ryan-james-thomas/analog-pi-servo/LaserPID.kicad_pcb

## KiCad design LaserPID.kicad_pcb (2024-05-08)

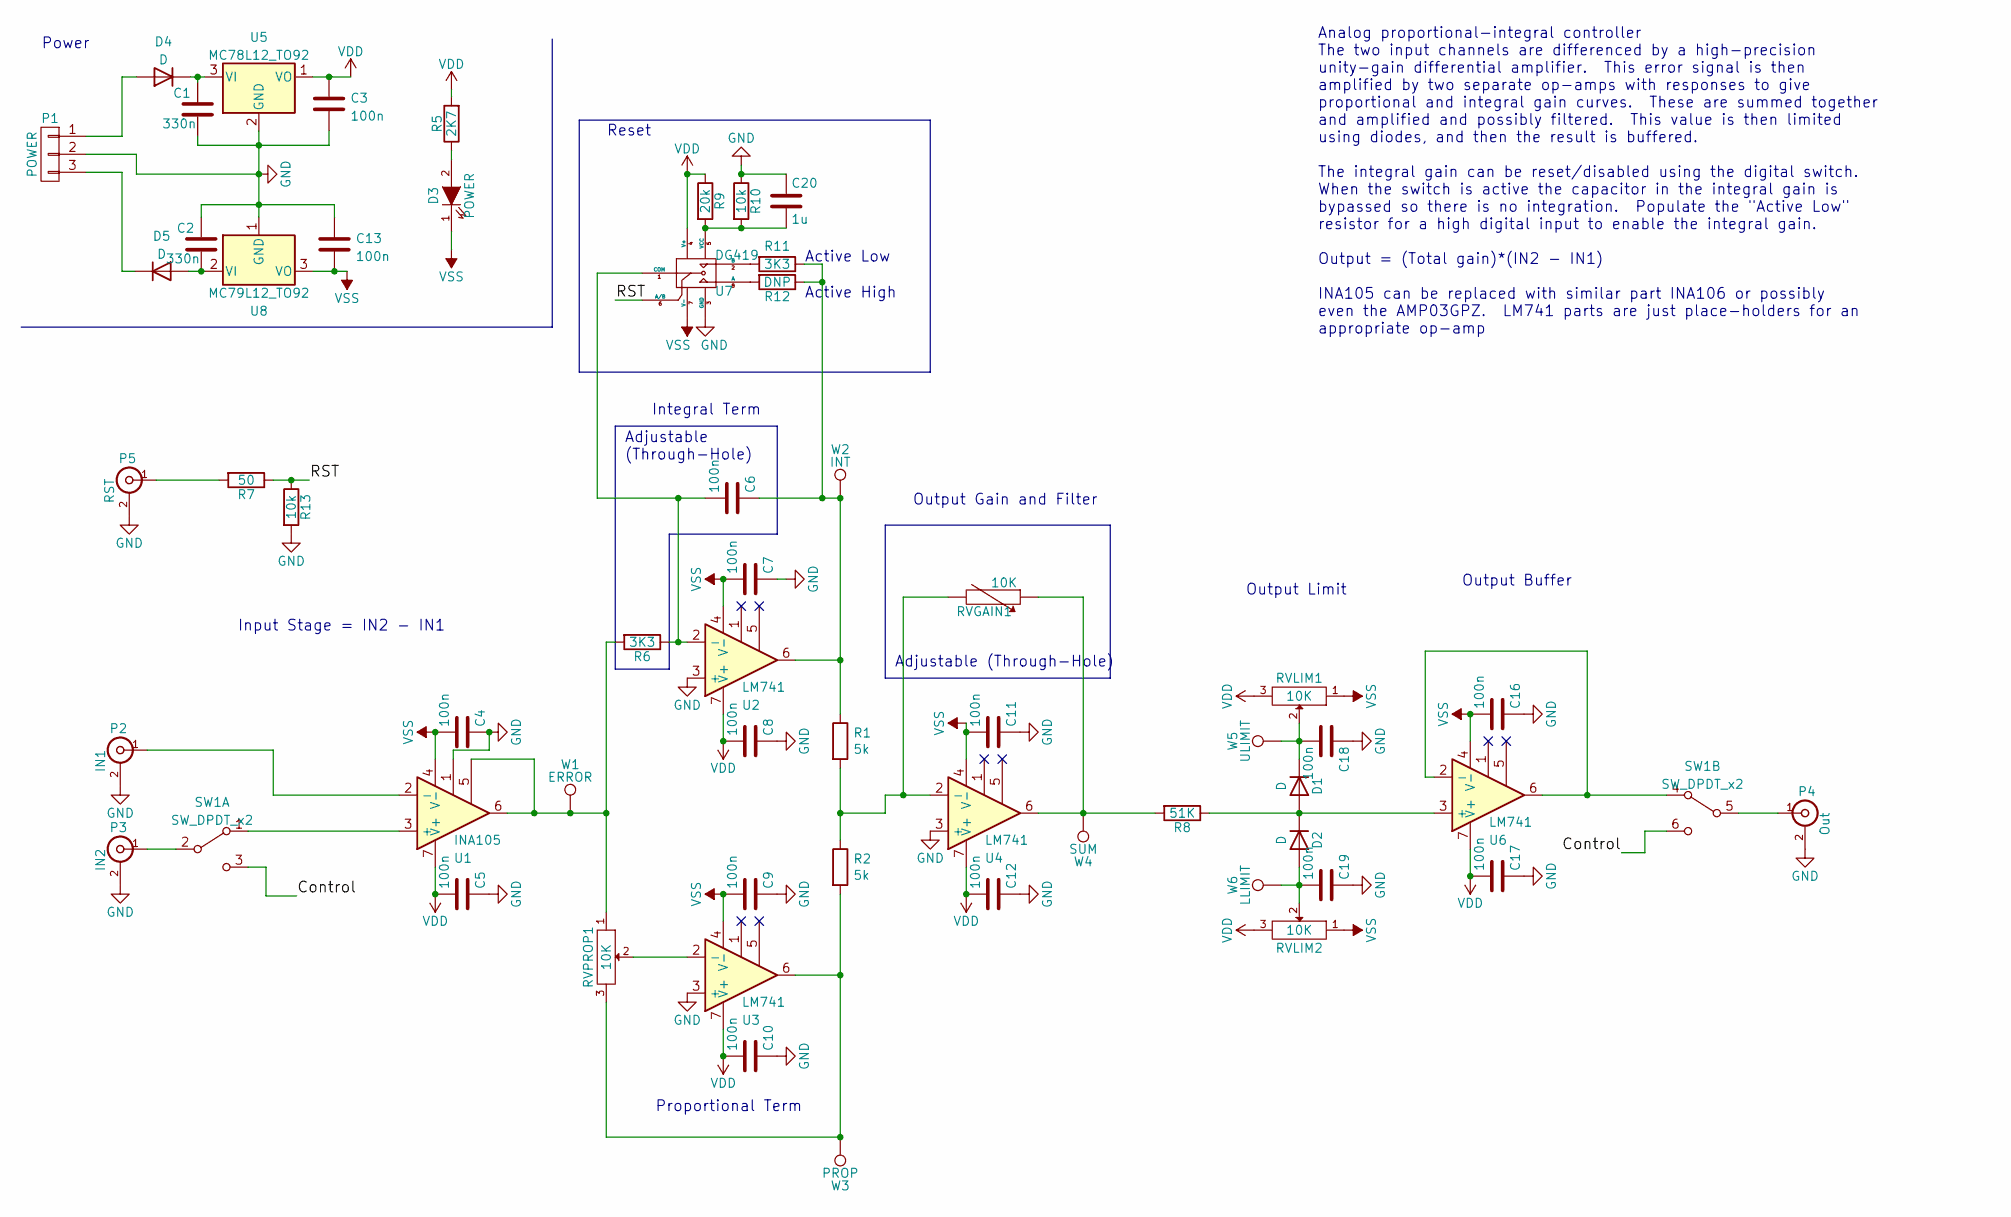
[picture p1: schematic LaserPID.kicad_sch, PI Contoller]

Parts:
C1, C2: 330n; C_1206_3216Metric_Pad1.33x1.80mm_HandSolder; Digikey Part Number 4713-GMC31X7R334K50NTCT-ND
C3, C4, C5, C7, C8, C9, C10, C11, C12, C13, C16, C17, C18, C19: 100n; C_1206_3216Metric_Pad1.33x1.80mm_HandSolder; Digikey Part Number 478-1556-1-ND
C6: 100n; R_Universal_L13.0mm_W4.0mm_P9.00mm
C20: 1u; C_1206_3216Metric_Pad1.33x1.80mm_HandSolder; Digikey Part Number 1276-2747-1-ND‎
D1, D2: D; D_DO-35_SOD27_P7.62mm_Horizontal; Digikey Part Number 1N4148FSCT-ND
D3: POWER; LED_D3.0mm; Digikey Part Number 732-5008-ND
D4, D5: D; D_1206_3216Metric_Pad1.42x1.75mm_HandSolder; Digikey Part Number 478-7806-1-ND
P1: POWER; TerminalBlock_bornier-3_P5.08mm; Digikey Part Number 2057-EBBA-03-C-SS-BU-ND
P2: IN1; BNC_Amphenol_B6252HB-NPP3G-50_Horizontal; Digikey Part Number ARF1690-ND
P3: IN2; BNC_Amphenol_B6252HB-NPP3G-50_Horizontal; Digikey Part Number ARF1690-ND
P4: Out; BNC_Amphenol_B6252HB-NPP3G-50_Horizontal; Digikey Part Number ARF1690-ND
P5: RST; BNC_Amphenol_B6252HB-NPP3G-50_Horizontal; Digikey Part Number ARF1690-ND
R1, R2: 5k; R_1206_3216Metric_Pad1.30x1.75mm_HandSolder; Digikey Part Number YAG5090CT-ND
R5: 2K7; R_1206_3216Metric_Pad1.30x1.75mm_HandSolder; Digikey Part Number RMCF1206JT2K70CT-ND
R6: 3K3; R_Universal_L13.0mm_W4.0mm_P9.00mm; Digikey Part Number RMCF1206JT3K30CT-ND
R7: 50; R_1206_3216Metric_Pad1.30x1.75mm_HandSolder; Digikey Part Number 541-2477-1-ND
R8: 51K; R_1206_3216Metric_Pad1.30x1.75mm_HandSolder; Digikey Part Number RMCF1206JT51K0CT-ND
R9: 20k; R_1206_3216Metric_Pad1.30x1.75mm_HandSolder; Digikey Part Number RMCF1206JT20K0CT-ND
R10, R13: 10k; R_1206_3216Metric_Pad1.30x1.75mm_HandSolder; Digikey Part Number RMCF1206JT10K0CT-ND
R11: 3K3; R_1206_3216Metric_Pad1.30x1.75mm_HandSolder; Digikey Part Number RMCF1206JT3K30CT-ND
R12: DNP; R_1206_3216Metric_Pad1.30x1.75mm_HandSolder
RVGAIN1: 10K; Potentiometer_Bourns_3296W_Vertical; Digikey Part Number 3296W-103LF-ND
RVLIM1, RVLIM2: 10K; Potentiometer_Bourns_3296W_Vertical; Digikey Part Number 3296W-103LF-ND
RVPROP1: 10K; Potentiometer_Bourns_3296W_Vertical; Digikey Part Number 3296W-103LF-ND
SW1: SW_DPDT_x2; DPDT_SW_ADAM_TECH; Digikey Part Number 2057-SW-T3-4B-A-A3-S2-ND
U1: INA105; DIP-8_W7.62mm_Socket; Digikey Part Number AMP03GPZ-ND
U2, U3, U4, U6: LM741; DIP-8_W7.62mm_Socket; Digikey Part Number 296-34251-5-ND
U5: MC78L12_TO92; TO-92_Inline; Digikey Part Number MC78L12ACPGOS-ND
U7: DG419; SOIC-8_3.9x4.9mm_P1.27mm; Digikey Part Number DG469EY-T1-E3CT-ND
U8: MC79L12_TO92; TO-92_Inline; Digikey Part Number MC79L12ACPGOS-ND
W1: ERROR; TestPoint_THTPad_D1.0mm_Drill0.5mm
W2: INT; TestPoint_THTPad_D1.0mm_Drill0.5mm
W3: PROP; TestPoint_THTPad_D1.0mm_Drill0.5mm
W4: SUM; TestPoint_THTPad_D1.0mm_Drill0.5mm
W5: ULIMIT; TestPoint_THTPad_D1.0mm_Drill0.5mm
W6: LLIMIT; TestPoint_THTPad_D1.0mm_Drill0.5mm

Connections:
/Control: SW1.3 (C), SW1.6 (C)
/RST: R7.1, R13.1, U7.6 (A/B)
GND: C1.2, C2.1, C3.2, C4.1, C5.1, C7.1, C8.1, C9.1, C10.1, C11.1, C12.1, C13.1, C16.1, C17.1, C18.1, C19.1, C20.1, P1.2, P2.2 (Ext), P3.2 (Ext), P4.2 (Ext), P5.2 (Ext), R10.1, R13.2, U1.1, U2.3 (+), U3.3 (+), U4.3 (+), U5.2 (GND), U7.3 (GND), U8.1 (GND)
unnamed: C6.1, R1.1, R11.1, R12.1, U2.6, W2.1
unnamed: C6.2, R6.1, U2.2 (-), U7.1 (COM)
unnamed 5: C18.2, D1.1 (K), RVLIM1.2, W5.1; also elsewhere on the board
unnamed 6: C19.2, D2.2 (A), RVLIM2.2, W6.1; also elsewhere on the board
unnamed: C20.2, R9.2, R10.2, U7.5 (VCC)
unnamed: D1.2 (A), D2.1 (K), R8.1, U6.3 (+)
unnamed: D3.2 (A), R5.1
unnamed: C1.1, D4.1 (K), U5.3 (VI)
unnamed: C2.2, D5.2 (A), U8.2 (VI)
unnamed: D4.2 (A), P1.1
unnamed: D5.1 (K), P1.3
unnamed: P2.1 (In), U1.2 (-)
unnamed: P3.1 (In), SW1.2 (B)
unnamed: P4.1 (In), SW1.5 (B)
unnamed: R1.2, R2.1, RVGAIN1.2, U4.2 (-)
unnamed: R2.2, RVPROP1.3, U3.6, W3.1
unnamed: R6.2, RVPROP1.1, U1.5, U1.6, W1.1
unnamed: P5.1 (In), R7.2
unnamed: R11.2, U7.2 (B)
unnamed: R12.2, U7.8 (A)
unnamed: R8.2, RVGAIN1.1, U4.6, W4.1
unnamed: RVPROP1.2, U3.2 (-)
unnamed: SW1.1 (A), U1.3 (+)
unnamed: SW1.4 (A), U6.2 (-), U6.6
VDD: C3.1, C5.2, C8.2, C10.2, C12.2, C17.2, R5.2, R9.1, RVLIM1.3, RVLIM2.3, U1.7 (V+), U2.7 (V+), U3.7 (V+), U4.7 (V+), U5.1 (VO), U6.7 (V+), U7.4 (V+); also elsewhere on the board
VSS: C4.2, C7.2, C9.2, C11.2, C13.2, C16.2, D3.1 (K), RVLIM1.1, RVLIM2.1, U1.4 (V-), U2.4 (V-), U3.4 (V-), U4.4 (V-), U6.4 (V-), U7.7 (V-), U8.3 (VO); also elsewhere on the board

Notes on the sheet:
Reset
Output Limit
Active High
Proportional Term
Input Stage = IN2 - IN1
Analog proportional-integral controller The two input channels are differenced by a high-precision unity-gain differential amplifier. This error signal is then amplified by two separate op-amps with responses to give proportional and integral gain curves. These are summed together and amplified and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
Output Buffer
Output Gain and Filter
Power
Adjustable (Through-Hole)
Integral Term
Active Low
Adjustable (Through-Hole)

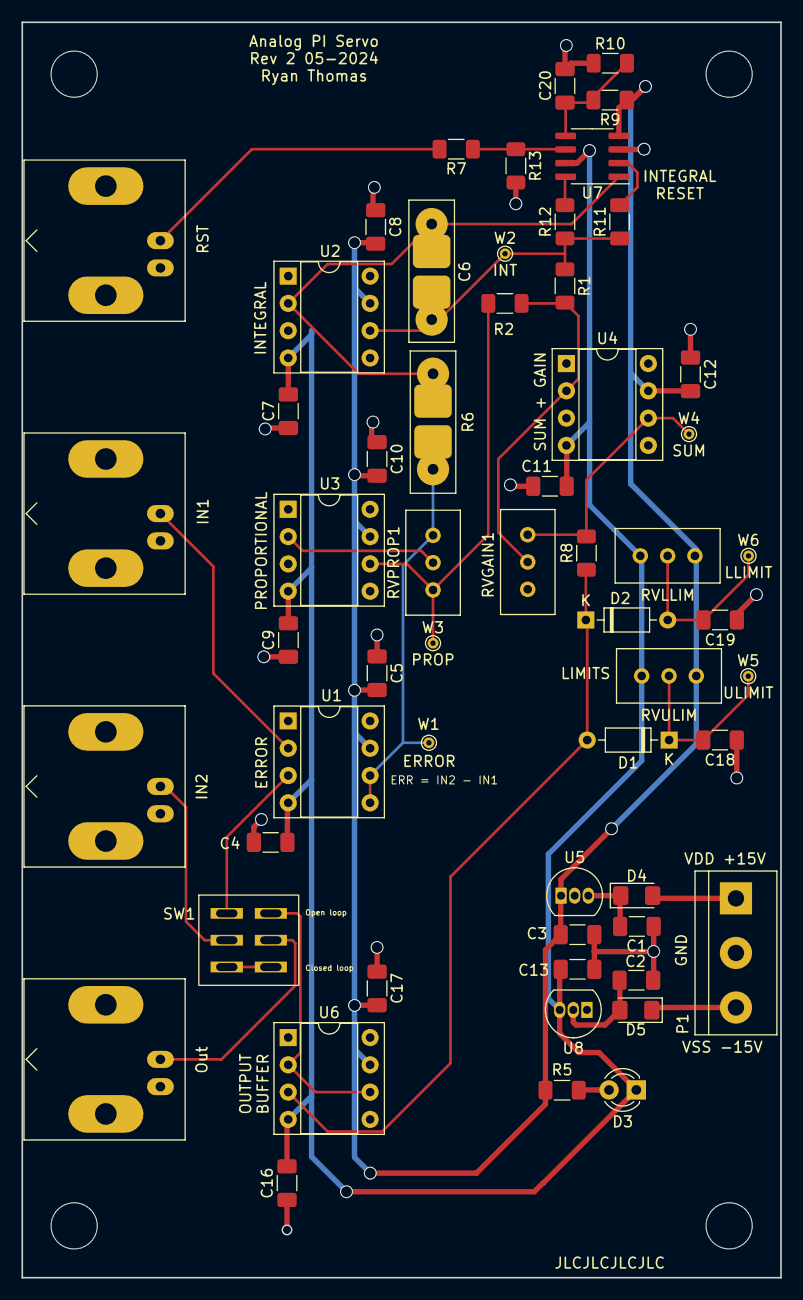
[picture p2: board LaserPID.kicad_pcb from above]

Board: 2 copper layers, 70.6 x 116.8 mm, 58 parts (0 on the bottom side), 29 nets.

Other parts of the board:
RVLLIM: 10K; Potentiometer_Bourns_3296W_Vertical
RVULIM: 10K; Potentiometer_Bourns_3296W_Vertical

Their connections:
unnamed 5: RVULIM.2; also elsewhere on the board
unnamed 6: RVLLIM.2; also elsewhere on the board
VDD: RVLLIM.3, RVULIM.3; also elsewhere on the board
VSS: RVLLIM.1, RVULIM.1; also elsewhere on the board
