ryan-james-thomas/analog-pi-servo/(commit log)

2024-05-06 Some updates to part list for no-longer-available parts
    [LaserPID.kicad_sch]
2024-05-07 Update to board with over- and reverse-voltage protection.
    Smaller board as well to fit in boxes from Digikey. All BNCs on
    the same side, power on opposite side. Switch included to go between
    open and closed loop control
    [LaserPID.kicad_pcb, LaserPID.kicad_sch]
2024-05-08 Updated board, sent for production
    [LaserPID-B_Cu.gbr, LaserPID-B_Mask.gbr, LaserPID-B_Paste.gbr, LaserPID-B_SilkS.gbr, LaserPID-B_Silkscreen.gbr, LaserPID-Edge_Cuts.gbr, LaserPID-F_Cu.gbr, LaserPID-F_Mask.gbr]
